sfilargi/stav-keeb-65/stav-keeb-65.kicad_pcb

## KiCad design stav-keeb-65.kicad_pcb (2026-07-15)

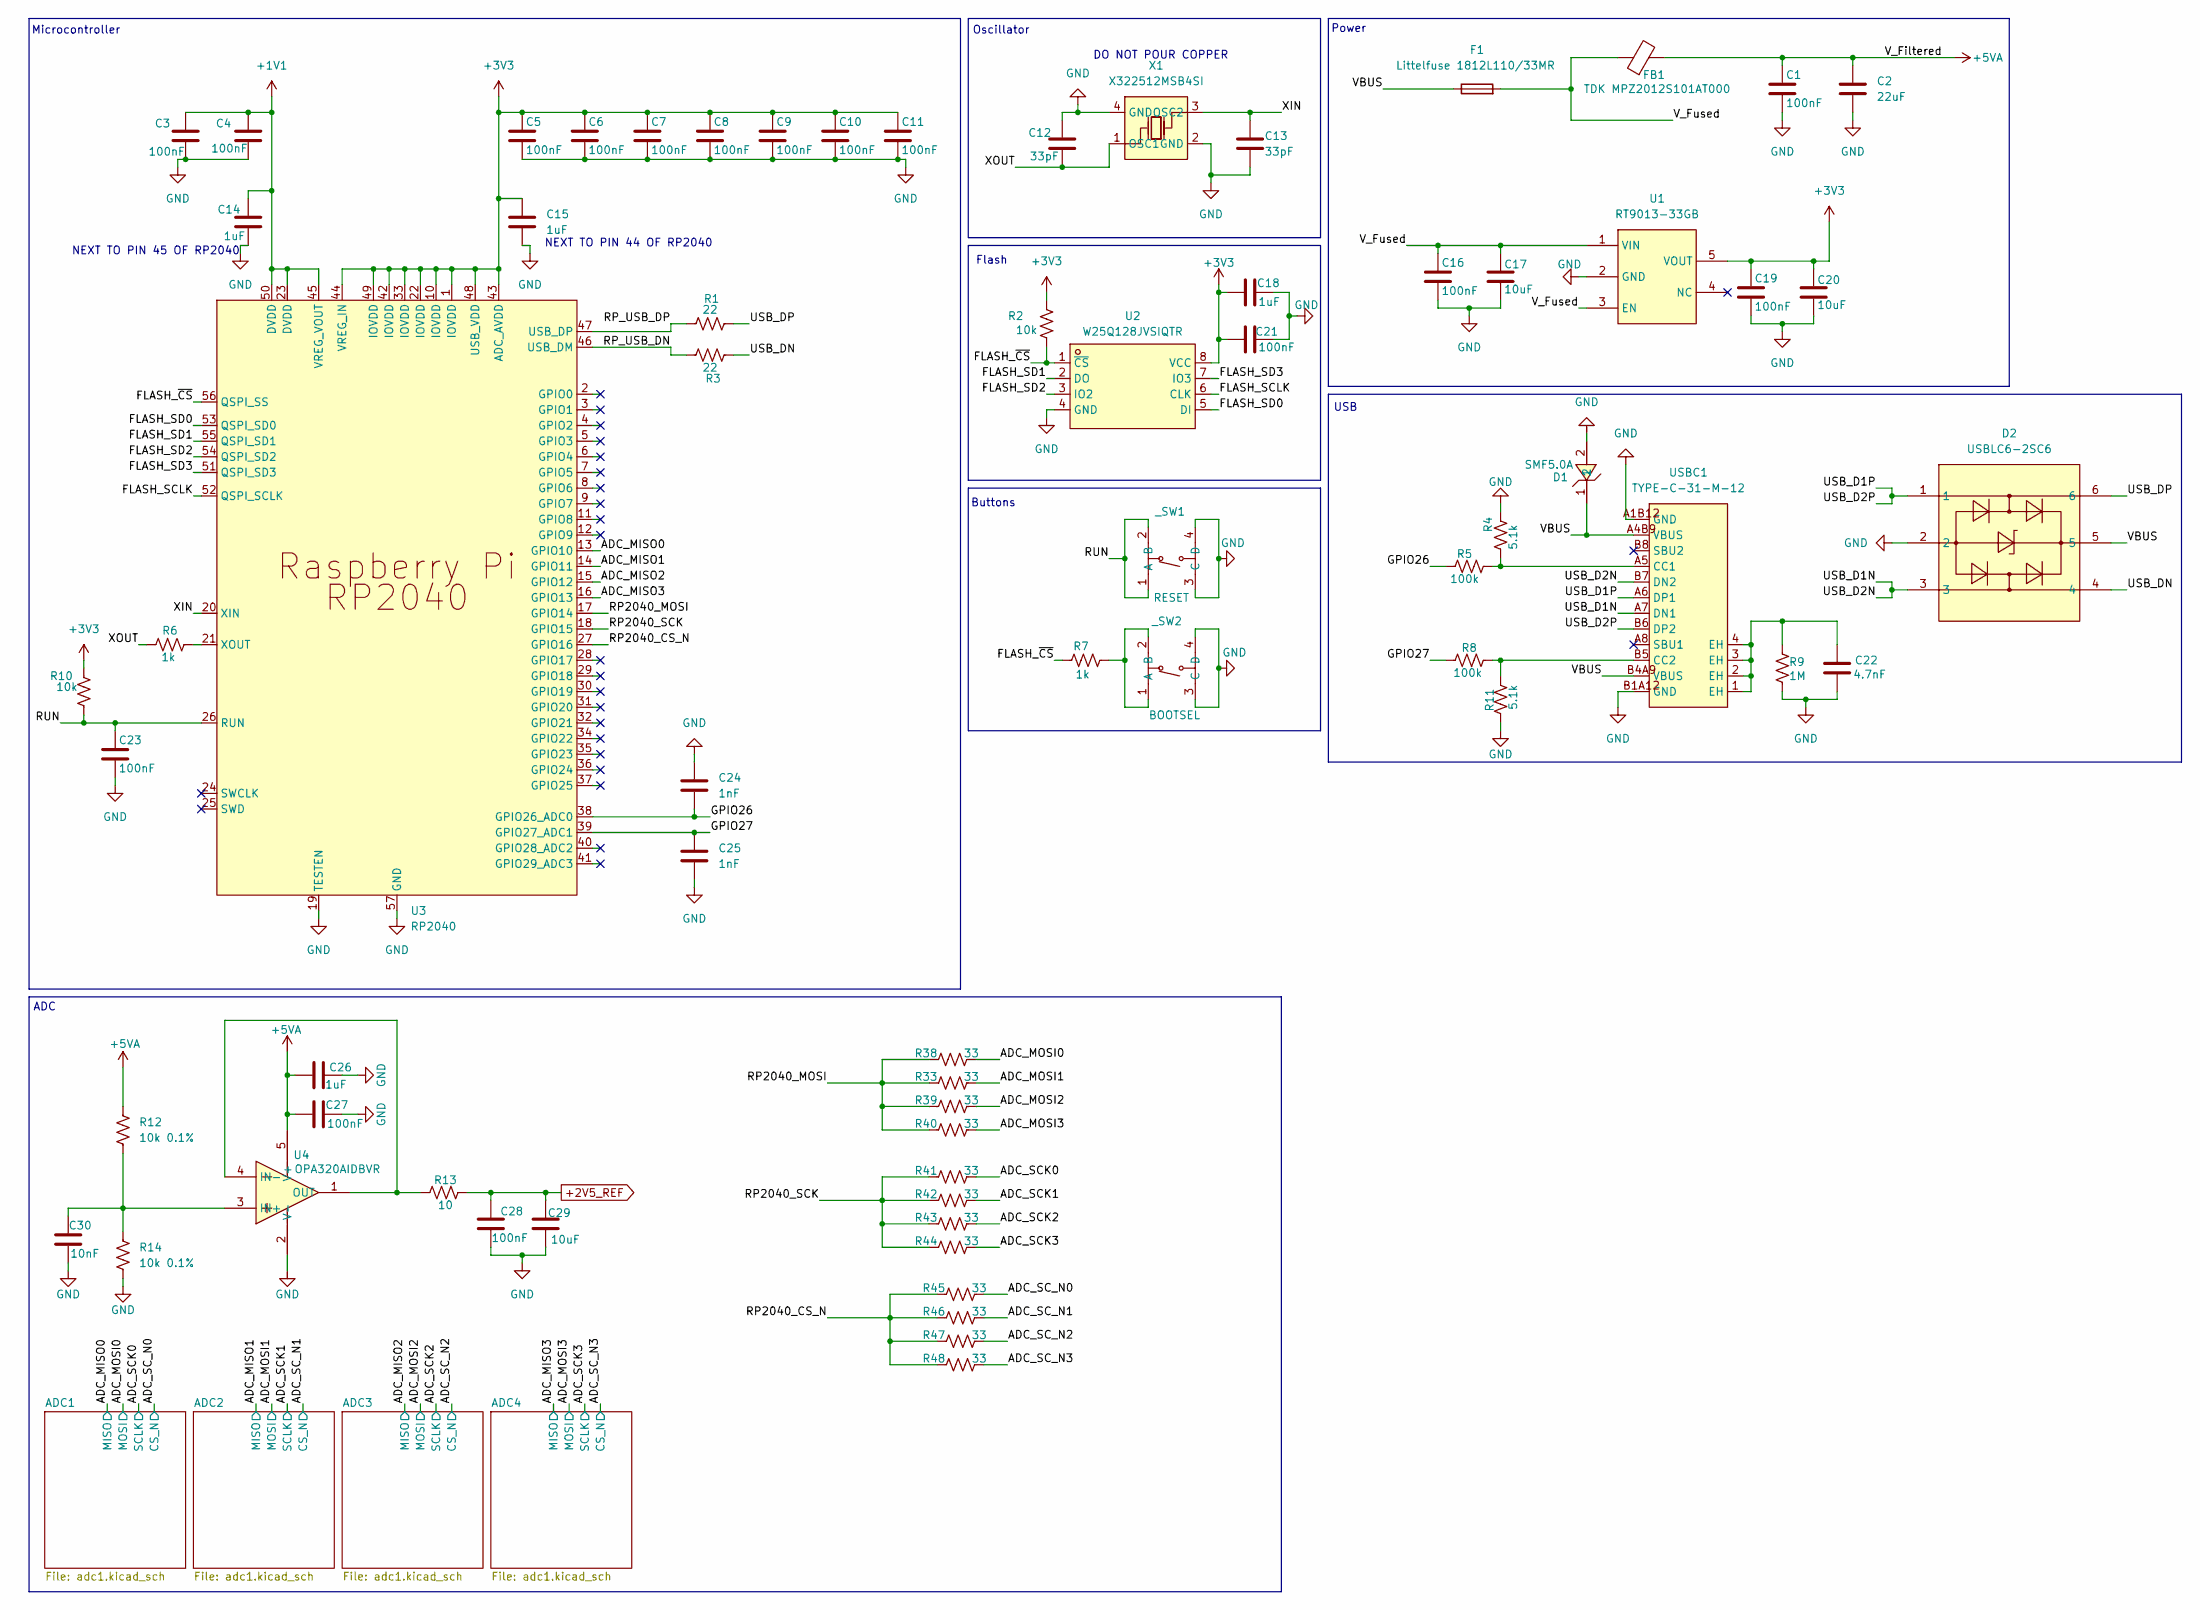
[picture p1: schematic stav-keeb-65.kicad_sch]

Parts:
C1, C16, C19: 100nF; C_1206_3216Metric; LCSC Part C14663
C2: 22uF; C_1206_3216Metric; LCSC Part C12891
C3, C4, C5, C6, C7, C8, C9, C10, C11, C21, C23, C27, C28: 100nF; C_0402_1005Metric; LCSC Part C14663
C12, C13: 33pF; C_0402_1005Metric; LCSC Part C1663
C14, C15, C18, C26: 1uF; C_0402_1005Metric; LCSC Part C15849
C17, C20: 10uF; C_1206_3216Metric; LCSC Part C13585
C22: 4.7nF; C_1206_3216Metric; LCSC Part C53987
C24, C25: 1nF; C_0402_1005Metric; LCSC Part C1588
C29: 10uF; C_1206_3216Metric_Pad1.33x1.80mm_HandSolder; LCSC Part C13585
C30: 10nF; C_0402_1005Metric; LCSC Part C57112
D1: SMF5.0A; SOD-123F_L2.8-W1.8-LS3.7-RD; MPN SMF5.0A; LCSC Part C151296
D2: USBLC6-2SC6; SOT-23-6_L2.9-W1.6-P0.95-LS2.8-BL; MPN USBLC6-2SC6; LCSC Part C7519
F1: Littelfuse 1812L110/33MR; Fuse_1812_4532Metric_Pad1.30x3.40mm_HandSolder; LCSC Part C142747
FB1: TDK MPZ2012S101AT000; L_0805_2012Metric_Pad1.05x1.20mm_HandSolder; LCSC Part C15957
R1, R3: 22; R_0402_1005Metric; LCSC Part C23345
R2, R10: 10k; R_0402_1005Metric; LCSC Part C25804
R4, R11: 5.1k; R_0402_1005Metric; LCSC Part C23186
R5, R8: 100k; R_0402_1005Metric; LCSC Part C25803
R6, R7: 1k; R_0402_1005Metric; LCSC Part C21190
R9: 1M; R_0402_1005Metric; LCSC Part C22935
R12, R14: 10k 0.1%; R_0603_1608Metric; LCSC Part C95204
R13: 10; R_0402_1005Metric; LCSC Part C22859
R33, R38, R39, R40, R41, R42, R43, R44, R45, R46, R47, R48: 33; R_0402_1005Metric; LCSC Part C23140
U1: RT9013-33GB; SOT-23-5_L3.0-W1.7-P0.95-LS2.8-BL; MPN RT9013-33GB; LCSC Part C47773
U2: W25Q128JVSIQTR; SOIC-8_L5.3-W5.3-P1.27-LS8.0-BL; MPN W25Q128JVSIQ; LCSC Part C97521
U3: RP2040; LQFN-56_L7.0-W7.0-P0.4-EP; MPN RP2040; LCSC Part C2040
U4: OPA320AIDBVR; SOT-23-5_L3.0-W1.7-P0.95-LS2.8-BR; MPN OPA320AIDBVR; LCSC Part C92494
USBC1: TYPE-C-31-M-12; USB-C_SMD-TYPE-C-31-M-12_1; MPN TYPE-C-31-M-12; LCSC Part C165948
X1: X322512MSB4SI; CRYSTAL-SMD_4P-L3.2-W2.5-BL; MPN X322512MSB4SI; LCSC Part C9002
_SW1: RESET; SW-SMD_4P-L5.1-W5.1-P3.70-LS6.5-TL_H1.5; MPN TS-1187A-B-A-B; LCSC Part C318884
_SW2: BOOTSEL; SW-SMD_4P-L5.1-W5.1-P3.70-LS6.5-TL_H1.5; MPN TS-1187A-B-A-B; LCSC Part C318884

Connections:
+1V1: C3.1, C4.1, C14.1, U3.23 (DVDD), U3.45 (VREG_VOUT), U3.50 (DVDD)
+2V5_REF: C28.2, C29.1, R13.2; also elsewhere on the board
+3V3: C5.1, C6.1, C7.1, C8.1, C9.1, C10.1, C11.1, C15.1, C18.2, C19.1, C20.1, C21.2, R2.1, R10.1, U1.5 (VOUT), U2.8 (VCC), U3.1 (IOVDD), U3.10 (IOVDD), U3.22 (IOVDD), U3.33 (IOVDD), U3.42 (IOVDD), U3.43 (ADC_AVDD), U3.44 (VREG_IN), U3.48 (USB_VDD), U3.49 (IOVDD); also elsewhere on the board
+5VA: C1.1, C2.1, C26.1, C27.2, FB1.2, R12.1, U4.5 (V+); also elsewhere on the board
/ADC_MISO0: U3.13 (GPIO10); also elsewhere on the board
/ADC_MISO1: U3.14 (GPIO11); also elsewhere on the board
/ADC_MISO2: U3.15 (GPIO12); also elsewhere on the board
/ADC_MISO3: U3.16 (GPIO13); also elsewhere on the board
/ADC_MOSI0: R38.2; also elsewhere on the board
/ADC_MOSI1: R33.2; also elsewhere on the board
/ADC_MOSI2: R39.2; also elsewhere on the board
/ADC_MOSI3: R40.2; also elsewhere on the board
/ADC_SCK0: R41.2; also elsewhere on the board
/ADC_SCK1: R42.2; also elsewhere on the board
/ADC_SCK2: R43.2; also elsewhere on the board
/ADC_SCK3: R44.2; also elsewhere on the board
/ADC_SC_N0: R45.2; also elsewhere on the board
/ADC_SC_N1: R46.2; also elsewhere on the board
/ADC_SC_N2: R47.2; also elsewhere on the board
/ADC_SC_N3: R48.2; also elsewhere on the board
/FLASH_SCLK: U2.6 (CLK), U3.52 (QSPI_SCLK)
/FLASH_SD0: U2.5 (DI), U3.53 (QSPI_SD0)
/FLASH_SD1: U2.2 (DO), U3.55 (QSPI_SD1)
/FLASH_SD2: U2.3 (IO2), U3.54 (QSPI_SD2)
/FLASH_SD3: U2.7 (IO3), U3.51 (QSPI_SD3)
/FLASH_~CS: R2.2, R7.1, U2.1 (~CS), U3.56 (QSPI_SS)
/GPIO26: C24.2, R5.1, U3.38 (GPIO26_ADC0)
/GPIO27: C25.1, R8.1, U3.39 (GPIO27_ADC1)
/RP2040_CS_N: R45.1, R46.1, R47.1, R48.1, U3.27 (GPIO16)
/RP2040_MOSI: R33.1, R38.1, R39.1, R40.1, U3.17 (GPIO14)
/RP2040_SCK: R41.1, R42.1, R43.1, R44.1, U3.18 (GPIO15)
/RP_USB_DN: R3.2, U3.46 (USB_DM)
/RP_USB_DP: R1.2, U3.47 (USB_DP)
/RUN: C23.1, R10.2, U3.26 (RUN), _SW1.1 (A), _SW1.2 (B)
/USB_D1N: D2.3, USBC1.A7 (DN1), USBC1.B7 (DN2)
/USB_D1P: D2.1, USBC1.A6 (DP1), USBC1.B6 (DP2)
/USB_DN: D2.4, R3.1
/USB_DP: D2.6, R1.1
/VBUS: D1.1, D2.5, F1.1, USBC1.A4B9 (VBUS), USBC1.B4A9 (VBUS)
/V_Fused: C16.1, C17.1, F1.2, FB1.1, U1.1 (VIN), U1.3 (EN)
/XIN: C13.1, U3.20 (XIN), X1.3 (OSC2)
/XOUT: C12.2, R6.1, X1.1 (OSC1)
GND: C1.2, C2.2, C3.2, C4.2, C5.2, C6.2, C7.2, C8.2, C9.2, C10.2, C11.2, C12.1, C13.2, C14.2, C15.2, C16.2, C17.2, C18.1, C19.2, C20.2, C21.1, C22.2, C23.2, C24.1, C25.2, C26.2, C27.1, C28.1, C29.2, C30.2, D1.2, D2.2, R4.2, R9.2, R11.2, R14.2, U1.2 (GND), U2.4 (GND), U3.19 (TESTEN), U3.57 (GND), U4.2 (V-), USBC1.A1B12 (GND), USBC1.B1A12 (GND), X1.2 (GND), X1.4 (GND), _SW1.3 (C), _SW1.4 (D), _SW2.3 (C), _SW2.4 (D); also elsewhere on the board
unnamed: C22.1, R9.1, USBC1.1 (EH), USBC1.2 (EH), USBC1.3 (EH), USBC1.4 (EH)
unnamed: R6.2, U3.21 (XOUT)
unnamed: C30.1, R12.2, R14.1, U4.3 (IN+)
unnamed: R13.1, U4.1 (OUT), U4.4 (IN-)
unnamed: R4.1, R5.2, USBC1.A5 (CC1)
unnamed: R8.2, R11.1, USBC1.B5 (CC2)
unnamed: R7.2, _SW2.1 (A), _SW2.2 (B)

Notes on the sheet:
Power
Oscillator
DO NOT POUR COPPER
Flash
NEXT TO PIN 45 OF RP2040
USB
ADC
Buttons
Microcontroller
NEXT TO PIN 44 OF RP2040

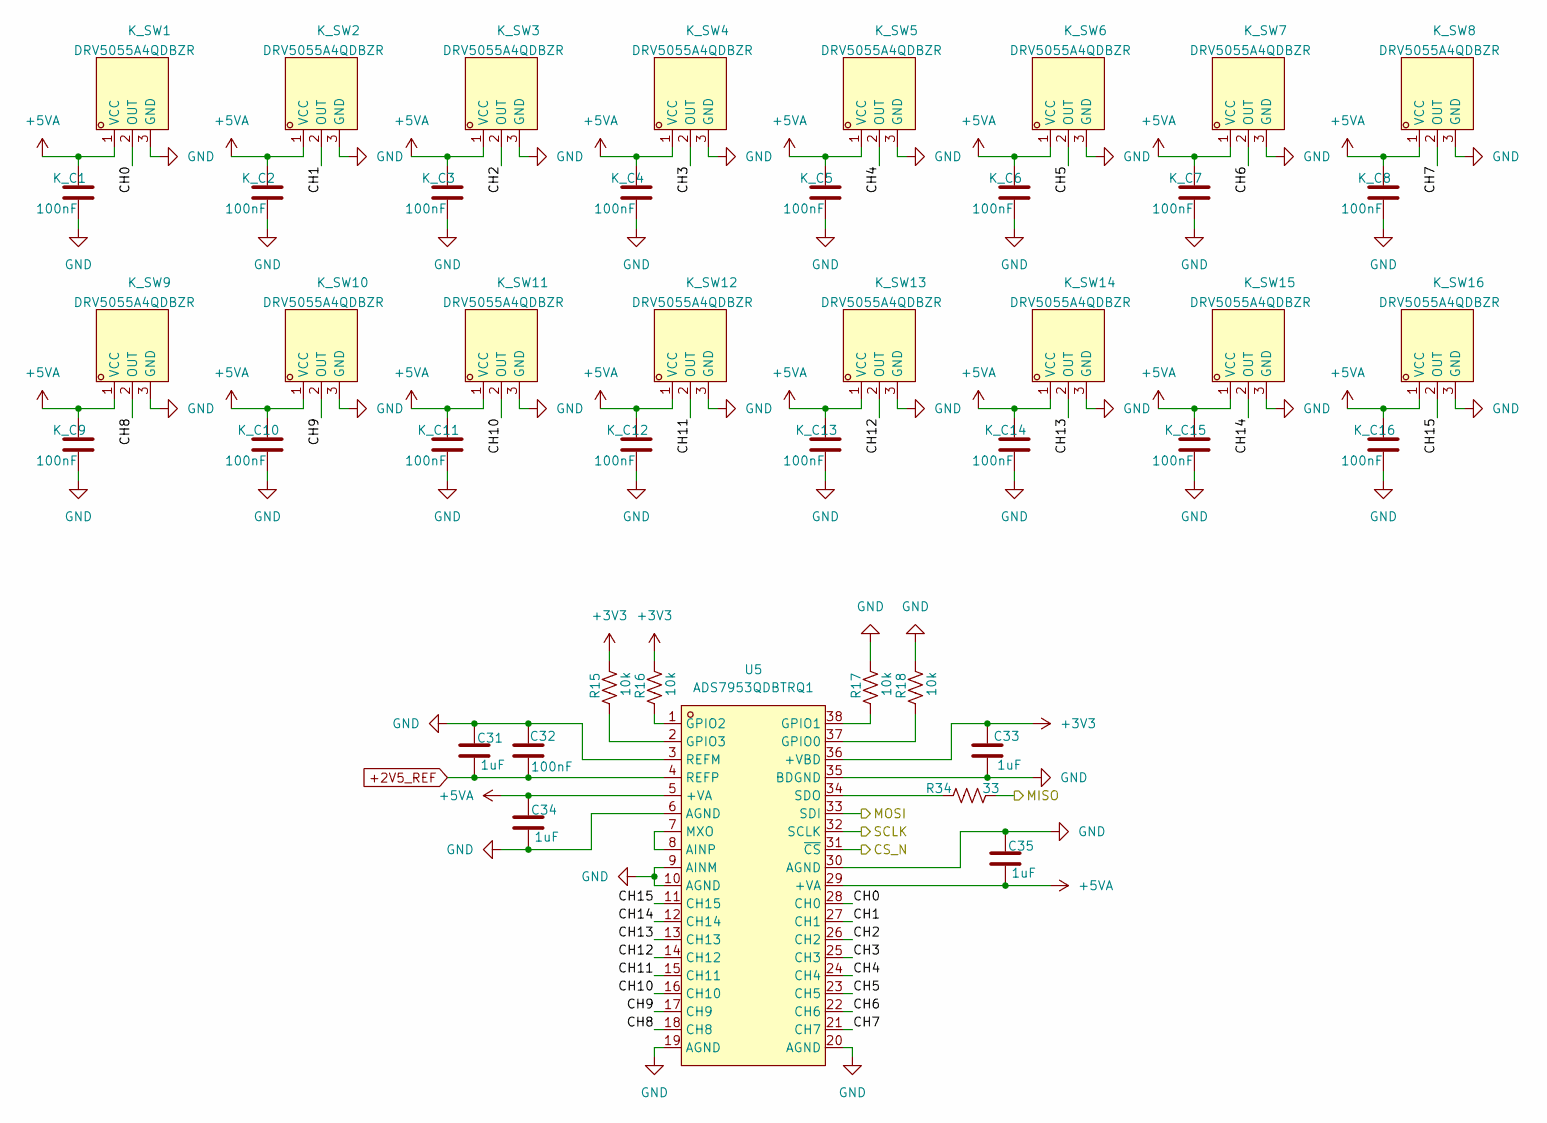
[picture p2: schematic adc1.kicad_sch, ADC 1]

Parts:
C31, C33, C34, C35: 1uF; C_0402_1005Metric; LCSC Part C15849
C32: 100nF; C_0402_1005Metric; LCSC Part C14663
K_C1, K_C2, K_C3, K_C4, K_C5, K_C6, K_C7, K_C8, K_C9, K_C10, K_C11, K_C12, K_C13, K_C14, K_C15, K_C16: 100nF; C_0402_1005Metric; LCSC Part C14663
K_SW1, K_SW2, K_SW3, K_SW4, K_SW5, K_SW6, K_SW7, K_SW8, K_SW9, K_SW10, K_SW11, K_SW12, K_SW13, K_SW14, K_SW15, K_SW16: DRV5055A4QDBZR; SOT-23-3_L2.9-W1.3-P1.90-LS2.4-BR; MPN DRV5055A4QDBZR; LCSC Part C266123
R15, R16, R17, R18: 10k; R_0402_1005Metric; LCSC Part C25804
R34: 33; R_0402_1005Metric; LCSC Part C23140
U5: ADS7953QDBTRQ1; TSSOP-38_L9.7-W4.4-P0.50-LS6.4-BL; MPN ADS7953QDBTRQ1; LCSC Part C701668

Connections:
+2V5_REF: C31.2, C32.1, U5.4 (REFP); also elsewhere on the board
+3V3: C33.1, R15.2, R16.2, U5.36 (+VBD); also elsewhere on the board
+5VA: C34.1, C35.2, K_C1.2, K_C2.2, K_C3.2, K_C4.2, K_C5.2, K_C6.2, K_C7.2, K_C8.2, K_C9.2, K_C10.2, K_C11.2, K_C12.2, K_C13.2, K_C14.2, K_C15.2, K_C16.2, K_SW1.1 (VCC), K_SW2.1 (VCC), K_SW3.1 (VCC), K_SW4.1 (VCC), K_SW5.1 (VCC), K_SW6.1 (VCC), K_SW7.1 (VCC), K_SW8.1 (VCC), K_SW9.1 (VCC), K_SW10.1 (VCC), K_SW11.1 (VCC), K_SW12.1 (VCC), K_SW13.1 (VCC), K_SW14.1 (VCC), K_SW15.1 (VCC), K_SW16.1 (VCC), U5.5 (+VA), U5.29 (+VA); also elsewhere on the board
/ADC1/CH0: K_SW1.2 (OUT), U5.28 (CH0)
/ADC1/CH1: K_SW2.2 (OUT), U5.27 (CH1)
/ADC1/CH2: K_SW3.2 (OUT), U5.26 (CH2)
/ADC1/CH3: K_SW4.2 (OUT), U5.25 (CH3)
/ADC1/CH4: K_SW5.2 (OUT), U5.24 (CH4)
/ADC1/CH5: K_SW6.2 (OUT), U5.23 (CH5)
/ADC1/CH6: K_SW7.2 (OUT), U5.22 (CH6)
/ADC1/CH7: K_SW8.2 (OUT), U5.21 (CH7)
/ADC1/CH8: K_SW9.2 (OUT), U5.18 (CH8)
/ADC1/CH9: K_SW10.2 (OUT), U5.17 (CH9)
/ADC1/CH10: K_SW11.2 (OUT), U5.16 (CH10)
/ADC1/CH11: K_SW12.2 (OUT), U5.15 (CH11)
/ADC1/CH12: K_SW13.2 (OUT), U5.14 (CH12)
/ADC1/CH13: K_SW14.2 (OUT), U5.13 (CH13)
/ADC1/CH14: K_SW15.2 (OUT), U5.12 (CH14)
/ADC1/CH15: K_SW16.2 (OUT), U5.11 (CH15)
/ADC_MISO0: R34.2; also elsewhere on the board
/ADC_MOSI0: U5.33 (SDI); also elsewhere on the board
/ADC_SCK0: U5.32 (SCLK); also elsewhere on the board
/ADC_SC_N0: U5.31 (~CS); also elsewhere on the board
GND: C31.1, C32.2, C33.2, C34.2, C35.1, K_C1.1, K_C2.1, K_C3.1, K_C4.1, K_C5.1, K_C6.1, K_C7.1, K_C8.1, K_C9.1, K_C10.1, K_C11.1, K_C12.1, K_C13.1, K_C14.1, K_C15.1, K_C16.1, K_SW1.3 (GND), K_SW2.3 (GND), K_SW3.3 (GND), K_SW4.3 (GND), K_SW5.3 (GND), K_SW6.3 (GND), K_SW7.3 (GND), K_SW8.3 (GND), K_SW9.3 (GND), K_SW10.3 (GND), K_SW11.3 (GND), K_SW12.3 (GND), K_SW13.3 (GND), K_SW14.3 (GND), K_SW15.3 (GND), K_SW16.3 (GND), R17.2, R18.2, U5.3 (REFM), U5.6 (AGND), U5.9 (AINM), U5.10 (AGND), U5.19 (AGND), U5.20 (AGND), U5.30 (AGND), U5.35 (BDGND); also elsewhere on the board
unnamed: U5.7 (MXO), U5.8 (AINP)
unnamed: R18.1, U5.37 (GPIO0)
unnamed: R17.1, U5.38 (GPIO1)
unnamed: R16.1, U5.1 (GPIO2)
unnamed: R15.1, U5.2 (GPIO3)
unnamed: R34.1, U5.34 (SDO)

Parts of its further copies:
C36, C38, C39, C40, C41, C43, C44, C45, C46, C48, C49, C50: 1uF; C_0402_1005Metric; LCSC Part C15849
C37, C42, C47: 100nF; C_0402_1005Metric; LCSC Part C14663
K_C17, K_C18, K_C19, K_C20, K_C21, K_C22, K_C23, K_C24, K_C25, K_C26, K_C27, K_C28, K_C29, K_C30, K_C31, K_C32, K_C33, K_C34, K_C35, K_C36, K_C37, K_C38, K_C39, K_C40, K_C41, K_C42, K_C43, K_C44, K_C45, K_C46, K_C47, K_C48, K_C49, K_C50, K_C51, K_C52, K_C53, K_C54, K_C55, K_C56, K_C57, K_C58, K_C59, K_C60, K_C61: 100nF; C_0402_1005Metric; LCSC Part C14663
K_SW17, K_SW18, K_SW19, K_SW20, K_SW21, K_SW22, K_SW23, K_SW24, K_SW25, K_SW26, K_SW27, K_SW28, K_SW29, K_SW30, K_SW31, K_SW32, K_SW33, K_SW34, K_SW35, K_SW36, K_SW37, K_SW38, K_SW39, K_SW40, K_SW41, K_SW42, K_SW43, K_SW44, K_SW45, K_SW46, K_SW47, K_SW48, K_SW49, K_SW50, K_SW51, K_SW52, K_SW53, K_SW54, K_SW55, K_SW56, K_SW57, K_SW58, K_SW59, K_SW60, K_SW61: DRV5055A4QDBZR; SOT-23-3_L2.9-W1.3-P1.90-LS2.4-BR; MPN DRV5055A4QDBZR; LCSC Part C266123
R19, R20, R21, R22, R23, R24, R25, R26, R27, R28, R29, R30: 10k; R_0402_1005Metric; LCSC Part C25804
R35, R36, R37: 33; R_0402_1005Metric; LCSC Part C23140
U6, U7, U8: ADS7953QDBTRQ1; TSSOP-38_L9.7-W4.4-P0.50-LS6.4-BL; MPN ADS7953QDBTRQ1; LCSC Part C701668

Connections of its further copies:
+2V5_REF: C36.2, C37.1, C41.2, C42.1, C46.2, C47.1, U6.4 (REFP), U7.4 (REFP), U8.4 (REFP); also elsewhere on the board
+3V3: C38.1, C43.1, C48.1, R19.2, R20.2, R23.2, R24.2, R27.2, R28.2, U6.36 (+VBD), U7.36 (+VBD), U8.36 (+VBD); also elsewhere on the board
+5VA: C39.1, C40.2, C44.1, C45.2, C49.1, C50.2, K_C17.2, K_C18.2, K_C19.2, K_C20.2, K_C21.2, K_C22.2, K_C23.2, K_C24.2, K_C25.2, K_C26.2, K_C27.2, K_C28.2, K_C29.2, K_C30.2, K_C31.2, K_C32.2, K_C33.2, K_C34.2, K_C35.2, K_C36.2, K_C37.2, K_C38.2, K_C39.2, K_C40.2, K_C41.2, K_C42.2, K_C43.2, K_C44.2, K_C45.2, K_C46.2, K_C47.2, K_C48.2, K_C49.2, K_C50.2, K_C51.2, K_C52.2, K_C53.2, K_C54.2, K_C55.2, K_C56.2, K_C57.2, K_C58.2, K_C59.2, K_C60.2, K_C61.2, K_SW17.1 (VCC), K_SW18.1 (VCC), K_SW19.1 (VCC), K_SW20.1 (VCC), K_SW21.1 (VCC), K_SW22.1 (VCC), K_SW23.1 (VCC), K_SW24.1 (VCC), K_SW25.1 (VCC), K_SW26.1 (VCC), K_SW27.1 (VCC), K_SW28.1 (VCC), K_SW29.1 (VCC), K_SW30.1 (VCC), K_SW31.1 (VCC), K_SW32.1 (VCC), K_SW33.1 (VCC), K_SW34.1 (VCC), K_SW35.1 (VCC), K_SW36.1 (VCC), K_SW37.1 (VCC), K_SW38.1 (VCC), K_SW39.1 (VCC), K_SW40.1 (VCC), K_SW41.1 (VCC), K_SW42.1 (VCC), K_SW43.1 (VCC), K_SW44.1 (VCC), K_SW45.1 (VCC), K_SW46.1 (VCC), K_SW47.1 (VCC), K_SW48.1 (VCC), K_SW49.1 (VCC), K_SW50.1 (VCC), K_SW51.1 (VCC), K_SW52.1 (VCC), K_SW53.1 (VCC), K_SW54.1 (VCC), K_SW55.1 (VCC), K_SW56.1 (VCC), K_SW57.1 (VCC), K_SW58.1 (VCC), K_SW59.1 (VCC), K_SW60.1 (VCC), K_SW61.1 (VCC), U6.5 (+VA), U6.29 (+VA), U7.5 (+VA), U7.29 (+VA), U8.5 (+VA), U8.29 (+VA); also elsewhere on the board
/ADC2/CH0: K_SW17.2 (OUT), U6.28 (CH0)
/ADC2/CH1: K_SW18.2 (OUT), U6.27 (CH1)
/ADC2/CH2: K_SW19.2 (OUT), U6.26 (CH2)
/ADC2/CH3: K_SW20.2 (OUT), U6.25 (CH3)
/ADC2/CH4: K_SW21.2 (OUT), U6.24 (CH4)
/ADC2/CH5: K_SW22.2 (OUT), U6.23 (CH5)
/ADC2/CH6: K_SW23.2 (OUT), U6.22 (CH6)
/ADC2/CH7: K_SW24.2 (OUT), U6.21 (CH7)
/ADC2/CH8: K_SW25.2 (OUT), U6.18 (CH8)
/ADC2/CH9: K_SW26.2 (OUT), U6.17 (CH9)
/ADC2/CH10: K_SW27.2 (OUT), U6.16 (CH10)
/ADC2/CH11: K_SW28.2 (OUT), U6.15 (CH11)
/ADC2/CH12: K_SW29.2 (OUT), U6.14 (CH12)
/ADC2/CH13: K_SW30.2 (OUT), U6.13 (CH13)
/ADC2/CH14: K_SW31.2 (OUT), U6.12 (CH14)
/ADC2/CH15: K_SW32.2 (OUT), U6.11 (CH15)
/ADC3/CH0: K_SW33.2 (OUT), U7.28 (CH0)
/ADC3/CH1: K_SW34.2 (OUT), U7.27 (CH1)
/ADC3/CH2: K_SW35.2 (OUT), U7.26 (CH2)
/ADC3/CH3: K_SW36.2 (OUT), U7.25 (CH3)
/ADC3/CH4: K_SW37.2 (OUT), U7.24 (CH4)
/ADC3/CH5: K_SW38.2 (OUT), U7.23 (CH5)
/ADC3/CH6: K_SW39.2 (OUT), U7.22 (CH6)
/ADC3/CH7: K_SW40.2 (OUT), U7.21 (CH7)
/ADC3/CH8: K_SW41.2 (OUT), U7.18 (CH8)
/ADC3/CH9: K_SW42.2 (OUT), U7.17 (CH9)
/ADC3/CH10: K_SW43.2 (OUT), U7.16 (CH10)
/ADC3/CH11: K_SW44.2 (OUT), U7.15 (CH11)
/ADC3/CH12: K_SW45.2 (OUT), U7.14 (CH12)
/ADC3/CH13: K_SW46.2 (OUT), U7.13 (CH13)
/ADC3/CH14: K_SW47.2 (OUT), U7.12 (CH14)
/ADC3/CH15: K_SW48.2 (OUT), U7.11 (CH15)
/ADC4/CH0: K_SW49.2 (OUT), U8.28 (CH0)
/ADC4/CH1: K_SW50.2 (OUT), U8.27 (CH1)
/ADC4/CH2: K_SW51.2 (OUT), U8.26 (CH2)
/ADC4/CH3: K_SW52.2 (OUT), U8.25 (CH3)
/ADC4/CH4: K_SW53.2 (OUT), U8.24 (CH4)
/ADC4/CH5: K_SW54.2 (OUT), U8.23 (CH5)
/ADC4/CH6: K_SW55.2 (OUT), U8.22 (CH6)
/ADC4/CH7: K_SW56.2 (OUT), U8.21 (CH7)
/ADC4/CH8: K_SW57.2 (OUT), U8.18 (CH8)
/ADC4/CH9: K_SW58.2 (OUT), U8.17 (CH9)
/ADC4/CH10: K_SW59.2 (OUT), U8.16 (CH10)
/ADC4/CH11: K_SW60.2 (OUT), U8.15 (CH11)
/ADC4/CH12: K_SW61.2 (OUT), U8.14 (CH12)
/ADC4/CH13: U8.13 (CH13)
/ADC4/CH14: U8.12 (CH14)
/ADC4/CH15: U8.11 (CH15)
/ADC_MISO1: R35.2; also elsewhere on the board
/ADC_MISO2: R36.2; also elsewhere on the board
/ADC_MISO3: R37.2; also elsewhere on the board
/ADC_MOSI1: U6.33 (SDI); also elsewhere on the board
/ADC_MOSI2: U7.33 (SDI); also elsewhere on the board
/ADC_MOSI3: U8.33 (SDI); also elsewhere on the board
/ADC_SCK1: U6.32 (SCLK); also elsewhere on the board
/ADC_SCK2: U7.32 (SCLK); also elsewhere on the board
/ADC_SCK3: U8.32 (SCLK); also elsewhere on the board
/ADC_SC_N1: U6.31 (~CS); also elsewhere on the board
/ADC_SC_N2: U7.31 (~CS); also elsewhere on the board
/ADC_SC_N3: U8.31 (~CS); also elsewhere on the board
GND: C36.1, C37.2, C38.2, C39.2, C40.1, C41.1, C42.2, C43.2, C44.2, C45.1, C46.1, C47.2, C48.2, C49.2, C50.1, K_C17.1, K_C18.1, K_C19.1, K_C20.1, K_C21.1, K_C22.1, K_C23.1, K_C24.1, K_C25.1, K_C26.1, K_C27.1, K_C28.1, K_C29.1, K_C30.1, K_C31.1, K_C32.1, K_C33.1, K_C34.1, K_C35.1, K_C36.1, K_C37.1, K_C38.1, K_C39.1, K_C40.1, K_C41.1, K_C42.1, K_C43.1, K_C44.1, K_C45.1, K_C46.1, K_C47.1, K_C48.1, K_C49.1, K_C50.1, K_C51.1, K_C52.1, K_C53.1, K_C54.1, K_C55.1, K_C56.1, K_C57.1, K_C58.1, K_C59.1, K_C60.1, K_C61.1, K_SW17.3 (GND), K_SW18.3 (GND), K_SW19.3 (GND), K_SW20.3 (GND), K_SW21.3 (GND), K_SW22.3 (GND), K_SW23.3 (GND), K_SW24.3 (GND), K_SW25.3 (GND), K_SW26.3 (GND), K_SW27.3 (GND), K_SW28.3 (GND), K_SW29.3 (GND), K_SW30.3 (GND), K_SW31.3 (GND), K_SW32.3 (GND), K_SW33.3 (GND), K_SW34.3 (GND), K_SW35.3 (GND), K_SW36.3 (GND), K_SW37.3 (GND), K_SW38.3 (GND), K_SW39.3 (GND), K_SW40.3 (GND), K_SW41.3 (GND), K_SW42.3 (GND), K_SW43.3 (GND), K_SW44.3 (GND), K_SW45.3 (GND), K_SW46.3 (GND), K_SW47.3 (GND), K_SW48.3 (GND), K_SW49.3 (GND), K_SW50.3 (GND), K_SW51.3 (GND), K_SW52.3 (GND), K_SW53.3 (GND), K_SW54.3 (GND), K_SW55.3 (GND), K_SW56.3 (GND), K_SW57.3 (GND), K_SW58.3 (GND), K_SW59.3 (GND), K_SW60.3 (GND), K_SW61.3 (GND), R21.2, R22.2, R25.2, R26.2, R29.2, R30.2, U6.3 (REFM), U6.6 (AGND), U6.9 (AINM), U6.10 (AGND), U6.19 (AGND), U6.20 (AGND), U6.30 (AGND), U6.35 (BDGND), U7.3 (REFM), U7.6 (AGND), U7.9 (AINM), U7.10 (AGND), U7.19 (AGND), U7.20 (AGND), U7.30 (AGND), U7.35 (BDGND), U8.3 (REFM), U8.6 (AGND), U8.9 (AINM), U8.10 (AGND), U8.19 (AGND), U8.20 (AGND), U8.30 (AGND), U8.35 (BDGND); also elsewhere on the board
unnamed: U6.7 (MXO), U6.8 (AINP)
unnamed: R22.1, U6.37 (GPIO0)
unnamed: R21.1, U6.38 (GPIO1)
unnamed: R20.1, U6.1 (GPIO2)
unnamed: R19.1, U6.2 (GPIO3)
unnamed: R35.1, U6.34 (SDO)
unnamed: U7.7 (MXO), U7.8 (AINP)
unnamed: R26.1, U7.37 (GPIO0)
unnamed: R25.1, U7.38 (GPIO1)
unnamed: R24.1, U7.1 (GPIO2)
unnamed: R23.1, U7.2 (GPIO3)
unnamed: R36.1, U7.34 (SDO)
unnamed: U8.7 (MXO), U8.8 (AINP)
unnamed: R30.1, U8.37 (GPIO0)
unnamed: R29.1, U8.38 (GPIO1)
unnamed: R28.1, U8.1 (GPIO2)
unnamed: R27.1, U8.2 (GPIO3)
unnamed: R37.1, U8.34 (SDO)

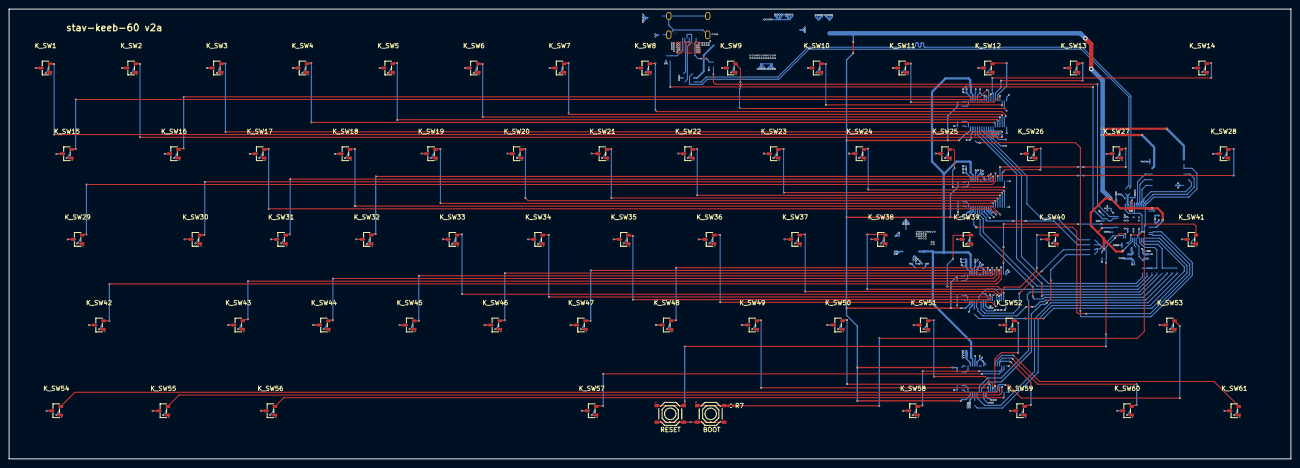
[picture p3: board stav-keeb-65.kicad_pcb from above]

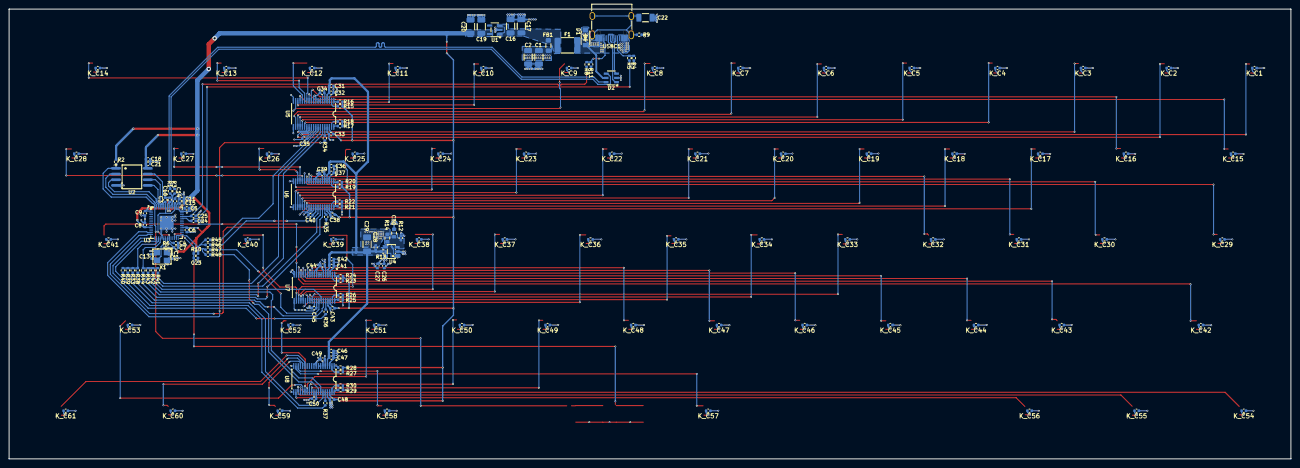
[picture p4: board stav-keeb-65.kicad_pcb from below]

Board: 4 copper layers, 285.0 x 100.0 mm, 234 parts (170 on the bottom side), 135 nets.
