sfilargi/stav-keeb-65/(commit log)

2026-07-04 hierarchical module
    [adc1.kicad_sch]
2026-07-04 RP2040 initial draw
    [adc1.kicad_sch, stav-keeb-65.kicad_sch]
2026-07-04 Oscillator and Flash
    [stav-keeb-65.kicad_sch]
2026-07-04 RESET & BOOTSEL BUTTONS
    [stav-keeb-65.kicad_sch]
2026-07-05 Power & USB
    [adc1.kicad_sch, stav-keeb-65.kicad_sch]
2026-07-05 USB connection to RP2040
    [stav-keeb-65.kicad_sch]
2026-07-05 2.5V ref
    [adc1.kicad_sch, stav-keeb-65.kicad_sch]
2026-07-05 Change 2.5V ref to voltage divider
    [adc1.kicad_sch, stav-keeb-65.kicad_sch]
2026-07-05 ERC fixes
    [stav-keeb-65.kicad_sch]
2026-07-05 Review fixes
    [adc1.kicad_sch, stav-keeb-65.kicad_sch]
2026-07-05 initial pcb and layout.json
    [stav-keeb-65.kicad_pcb, stav-keeb-65.kicad_sch]
2026-07-05 initial script for sensor placement, and schematic fixes
    [adc1.kicad_sch, stav-keeb-65.kicad_sch]
2026-07-05 some more schematic fixes
    [adc1.kicad_sch, stav-keeb-65.kicad_pcb]
2026-07-05 remove 0 value resistors
    [adc1.kicad_sch]
2026-07-05 PCB rough placements
    [stav-keeb-65.kicad_pcb]
2026-07-07 PCB layout v1
    [adc1.kicad_sch, stav-keeb-65.kicad_pcb, stav-keeb-65.kicad_sch]
2026-07-07 PCB layout final v1
    [stav-keeb-65.kicad_pcb]
2026-07-07 3d changes and text
    [stav-keeb-65.kicad_pcb]
2026-07-07 Sent to JLCPCB
    [stav-keeb-65.kicad_pcb]
2026-07-13 progress towards v2
    [adc1.kicad_sch, stav-keeb-65.kicad_pcb, stav-keeb-65.kicad_sch]
2026-07-14 more progress towards v2
    [adc1.kicad_sch, stav-keeb-65.kicad_pcb, stav-keeb-65.kicad_sch]
2026-07-15 closer to v2
    [stav-keeb-65.kicad_pcb, stav-keeb-65.kicad_sch]
2026-07-15 version v2a
    [stav-keeb-65.kicad_pcb]
2026-07-15 gnd pour on top and bottom layer. some more fixes
